peterjbunyan/Liightgun/README.md

# Liightgun
Lightgun upgrade kit to utilize a wiimote camera and 4 IR points for screentracking.

Forked under original CC Attribution-ShareAlike 4.0 from [Mysli0210/Liightgun](https://github.com/Mysli0210/Liightgun)

Updated to use SMD components
