peterjbunyan/Liightgun/Jigs/wiicam-solder-jig.stl

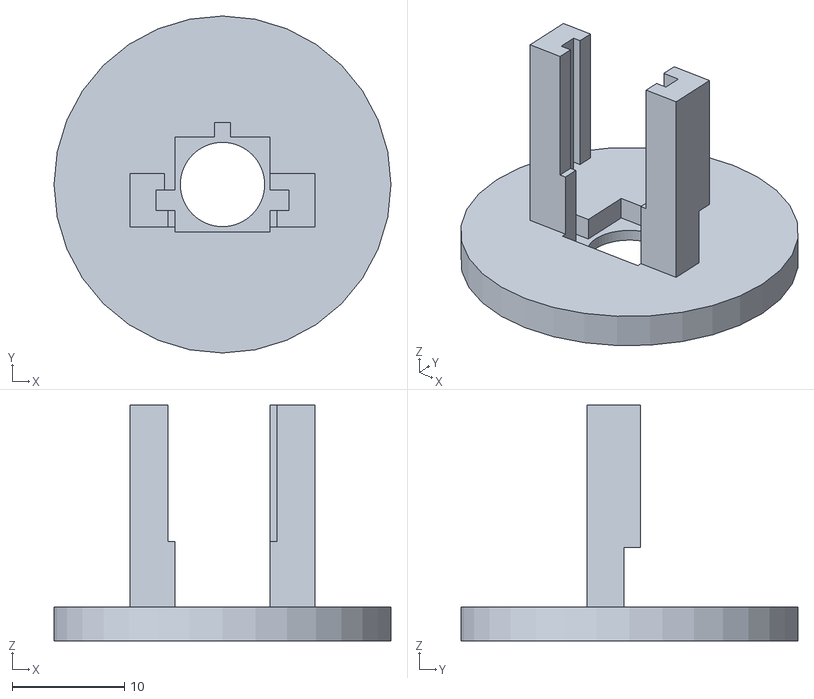
[picture p1: CAD file, 2022-05-16]
Jigs/wiicam-solder-jig.stl
30.0 x 30.0 x 21.0
