peterjbunyan/Liightgun/wiicam/Mount STLs/Wiicam Mount - Logic 3 Predator.stl

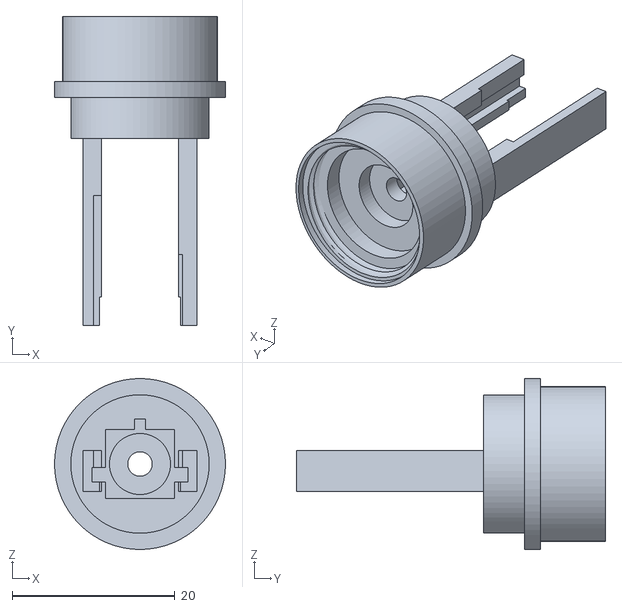
[picture p2: CAD file, 2022-08-13]
wiicam/Mount STLs/Wiicam Mount - Logic 3 Predator.stl
21.0 x 38.0 x 21.0
