peterjbunyan/Liightgun/wiicam/Mount STLs/Wiicam Mount - ODCON.stl

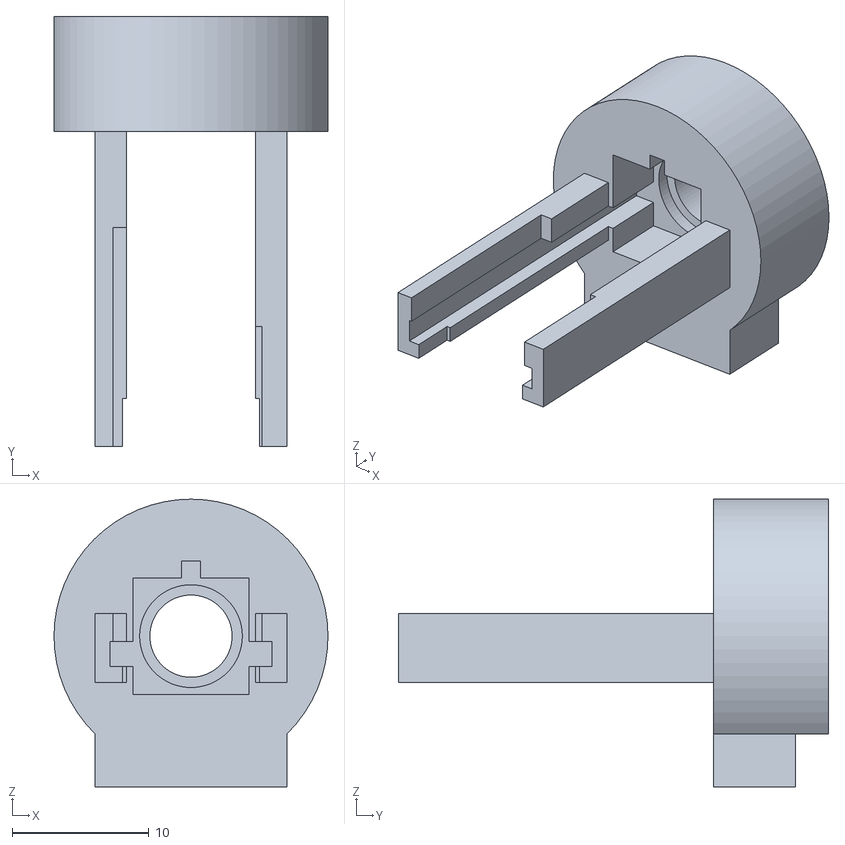
[picture p3: CAD file, 2022-08-13]
wiicam/Mount STLs/Wiicam Mount - ODCON.stl
20.0 x 31.4 x 21.0
