peterjbunyan/Liightgun/wiicam/Mount STLs/Wiicam Mount - Blaze Scorpion.stl

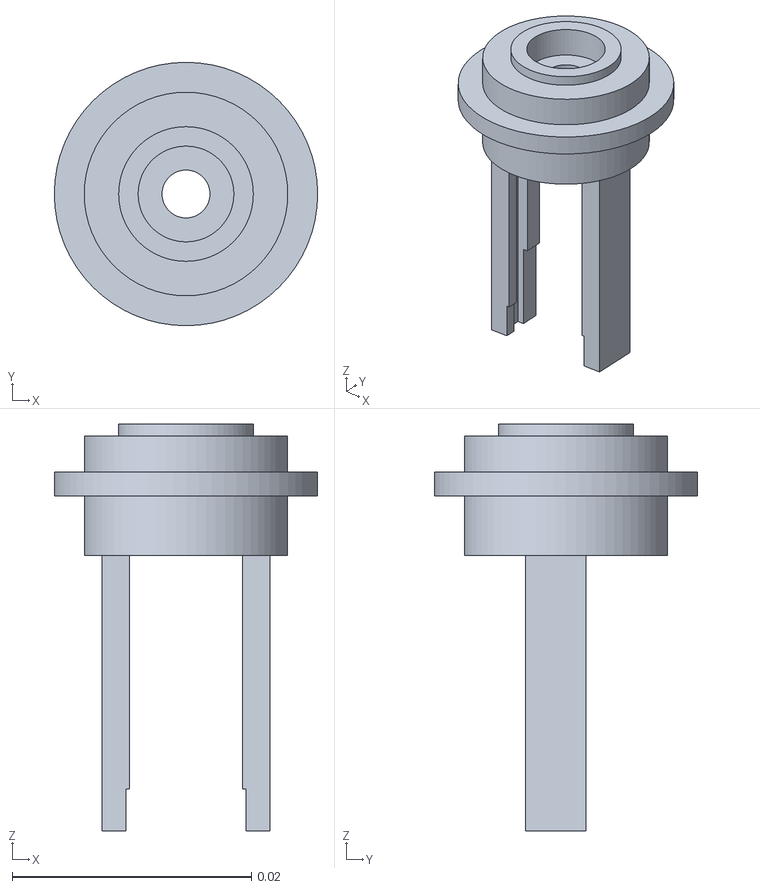
[picture p4: CAD file, 2022-08-13]
wiicam/Mount STLs/Wiicam Mount - Blaze Scorpion.stl
0.022 x 0.022 x 0.034
