peterjbunyan/Liightgun/wiicam/wiicam.kicad_pcb

## KiCad design wiicam/wiicam.kicad_pcb (2022-05-16)

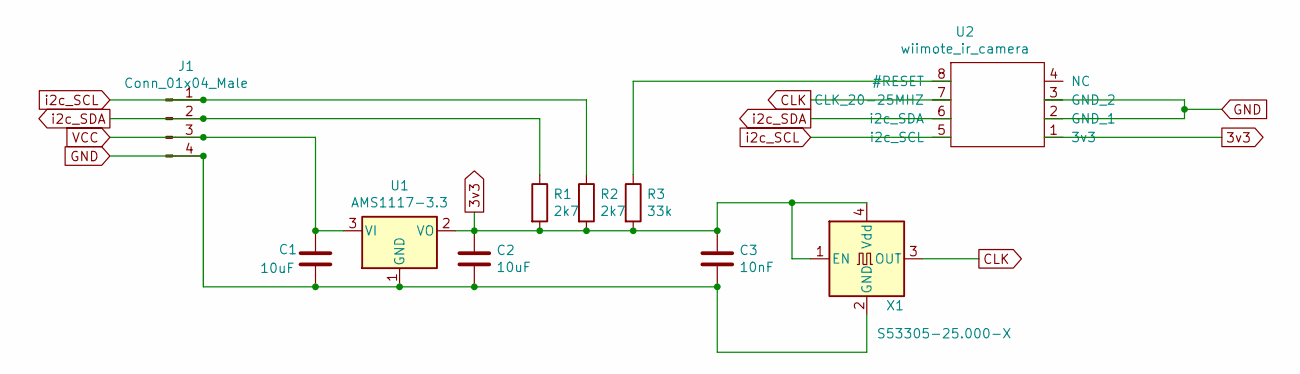
[picture p5: schematic wiicam.sch]

Parts:
C1, C2: 10uF; C_0805_2012Metric_Pad1.18x1.45mm_HandSolder
C3: 10nF; C_0805_2012Metric_Pad1.18x1.45mm_HandSolder
J1: Conn_01x04_Male; PinHeader_1x04_P2.54mm_Horizontal
R1, R2: 2k7; R_0805_2012Metric_Pad1.20x1.40mm_HandSolder
R3: 33k; R_0805_2012Metric_Pad1.20x1.40mm_HandSolder
U1: AMS1117-3.3; SOT-223-3_TabPin2
U2: wiimote_ir_camera; wii_ir_cam
X1: S53305-25.000-X; Oscillator_SMD_TXC_7C-4Pin_5.0x3.2mm_HandSoldering

Connections:
3v3: C2.1, C3.1, R1.2, R2.2, R3.2, U1.2 (VO), U2.1 (3v3), X1.1 (EN), X1.4 (Vdd)
CLK: U2.7 (CLK_20-25MHZ), X1.3 (OUT)
GND: C1.2, C2.2, C3.2, J1.4, U1.1 (GND), U2.2 (GND_1), U2.3 (GND_2), X1.2 (GND)
unnamed: R3.1, U2.8 (#RESET)
VCC: C1.1, J1.3, U1.3 (VI)
i2c_SCL: J1.1, R2.1, U2.5 (i2c_SCL)
i2c_SDA: J1.2, R1.1, U2.6 (i2c_SDA)

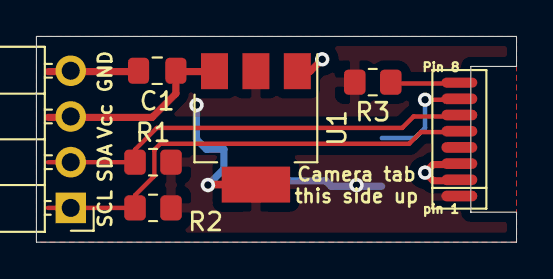
[picture p6: board wiicam.kicad_pcb from above]

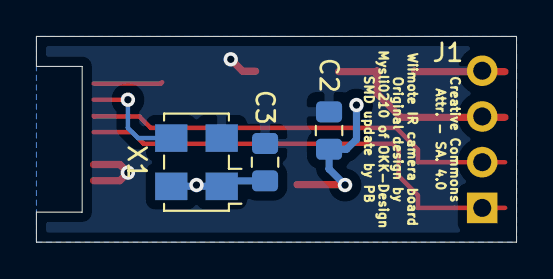
[picture p7: board wiicam.kicad_pcb from below]

Board: 2 copper layers, 26.7 x 11.4 mm, 10 parts (3 on the bottom side), 7 nets.
