peterjbunyan/Liightgun/(commit log)

2022-04-29 Update with available SMD components
    Change to SMD components and change the regulator to what I have on hand
    [wiicam.sch]
2022-04-30 Update footprint with measured pad dimensions
2022-04-30 Update PCB to SMD components and new footprint
    [wiicam.kicad_pcb]
2022-04-30 Add generated gerbers
    [wiicam-B_Cu.gbl, wiicam-B_Mask.gbs, wiicam-B_Paste.gbp, wiicam-B_SilkS.gbo, wiicam-Edge_Cuts.gm1, wiicam-F_Cu.gtl, wiicam-F_Mask.gts, wiicam-F_Paste.gtp]
2022-05-16 Remove OSC output capacitor Output capacitor value is too high - S53305-25.000-X is rated at max 15pF output load
    [wiicam-B_Cu.gbl, wiicam-B_Mask.gbs, wiicam-B_Paste.gbp, wiicam-B_SilkS.gbo, wiicam-Edge_Cuts.gm1, wiicam-F_Cu.gtl, wiicam-F_Mask.gts, wiicam-F_Paste.gtp]
2022-05-16 Added jig to help solder wiicam board to camera
    [wiicam-solder-jig.stl]
2022-08-13 Add Wiicam mounting STLs
    [Wiicam Mount - Blaze Scorpion.stl, Wiicam Mount - Logic 3 Predator.stl, Wiicam Mount - ODCON.stl]
