peterjbunyan/Liightgun/(notices)

Notices in the files:
wiicam/wiicam.kicad_pcb:
Creative Commons
Attr. - SA. 4.0
